RancesTello/NERO/hardware/stl/README.md

# Piezas impresas en 3D

La estructura mecánica de NERO está basada en [EduExo Maker](https://www.eduexo.com/), el exoesqueleto educativo de código abierto de Auxivo AG. Los archivos de esta carpeta son versiones modificadas de dos piezas de EduExo: el logotipo original se reemplazó por una placa con el nombre NERO. La geometría funcional (agujeros, alojamiento del servo y uniones) no cambió.

| Archivo | Pieza original de EduExo | Cambio |
|---|---|---|
| `Upper_Arm_Segment_NERO.stl` | `Upper_Arm_Segment.stl` | Placa de 1,2 mm con "NERO" en relieve de 1 mm sobre la cara exterior |
| `Interface_Motor_Sensor_NERO.stl` | `Interface_Motor_Sensor.stl` | Placa de 1,2 mm con "NERO" en relieve de 1 mm sobre la cara inferior |

Las demás piezas (antebrazo, adaptador del motor y brazaletes) se usan sin cambios. Descárgalas del sitio de EduExo, junto con el manual de armado.

Unidades en milímetros. Las piezas del prototipo se imprimieron en PLA blanco.

Estas piezas derivan del diseño de EduExo y no están cubiertas por la licencia MIT del repositorio. Se rigen por los términos de EduExo.
