RancesTello/NERO/hardware/stl/Upper_Arm_Segment_NERO.stl

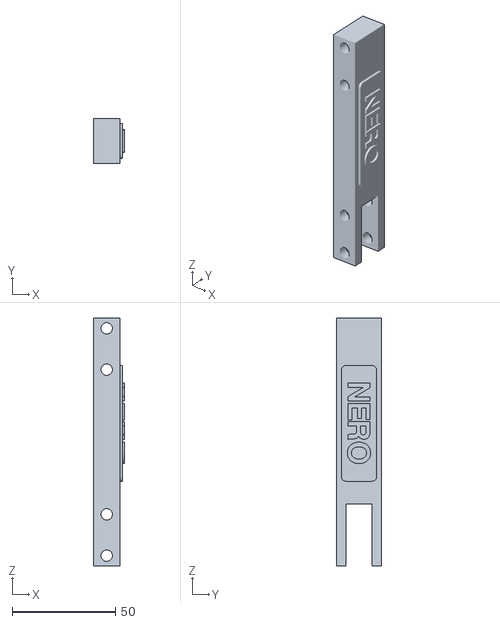
[picture p4: CAD file, 2026-11-01]
hardware/stl/Upper_Arm_Segment_NERO.stl
14.9 x 22.0 x 120.0
