RancesTello/NERO/hardware/stl/Interface_Motor_Sensor_NERO.stl

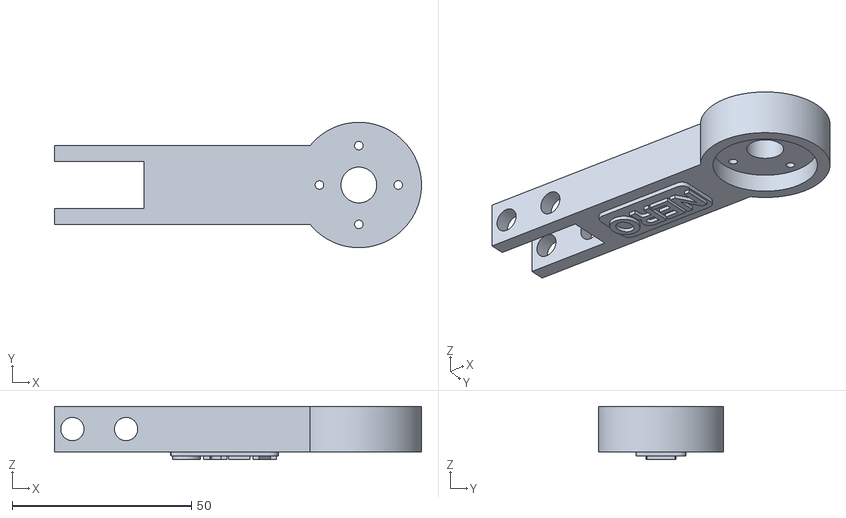
[picture p5: CAD file, 2026-11-01]
hardware/stl/Interface_Motor_Sensor_NERO.stl
102.5 x 35.0 x 14.9
