RancesTello/NERO/firmware/Lily_SuperSet/secrets.example.h

// PLANTILLA: copia este archivo como secrets.h y completa tus valores.
// secrets.h está en .gitignore y NO se sube al repositorio.
#ifndef SECRETS_H
#define SECRETS_H

#define SECRET_WIFI_SSID "TU_RED_WIFI"
#define SECRET_WIFI_PASSWORD "TU_PASSWORD_WIFI"

#endif
