RancesTello/NERO/(commit log)

2026-11-01 Publicación inicial de NERO
    Firmware (configuraciones A y B), servidor PostgreSQL + Superset en Docker,
    puente UDP, taller de IEEE EMBS y prototipos por sensor.
2026-11-01 Agrega las piezas de EduExo modificadas con el nombre NERO
    Corrige Interface_Motor_Sensor_NERO.stl: un resto de la letra "o" del
    logotipo original quedaba fuera de la placa.
    [Interface_Motor_Sensor_NERO.stl, Upper_Arm_Segment_NERO.stl]
2026-11-01 Agrega la sección de reconocimientos y prensa
2026-11-01 Agrega el primer lugar en LEIRD 2025 a reconocimientos
2026-11-01 Agrega el ORCID de Luiyiana Pérez
